Lavender-6/SmartGuard/(commit log)

2026-11-01 feat: 智能安防门禁系统（ESP32-S3 + STM32F103 双控制器）
    - firmware/esp32: 门禁主控，FreeRTOS 五任务 + 三态状态机 + 多传感器驱动
    - firmware/stm32: 物理按键控制器，寄存器级裸机 + ESP8266 AT/HTTP 客户端
    - dashboard: Node.js 零依赖网页看板，单一真相源 + 有效模式折算
    - docs: 设计报告（md/docx）与 PPT 制作指南
    - tools: Windows 一键启动看板脚本
    [wchlink_stm32f103.cfg]
2026-11-01 docs: 按实际物料修正硬件清单
    - ESP32-S3-DevKitC-1 → ESP32-S3 核心板
    - 移除 AMS1117 独立稳压模块（实际使用自制 ESP 底座）
    - 新增 面包板 + 自制 ESP 部分底座
    - 移除 109 元成本估算（与实际清单不再对应）
